neutronstriker/Programmable_Bench_Power_Supply/README.md

# Programmable_Bench_Power_Supply
An opensource Programmable benchtop Power Supply
