neutronstriker/Programmable_Bench_Power_Supply/Code/AVR/Digital_PSU/working_copy/Digital_PSU/serial cmd repl design.xlsx

Sheet: Sheet1
Prefix | Cmd Number | Aux string | cmd String | suffix | space | Comments | Var declaration | Help output prefix | help output cmd, comment sep | Help output suffix | Help output code
const char PROGMEM cmd | 1 | []=" | on | "; | // | Turn output on | const char PROGMEM cmd1[]="on"; //Turn output on | Serial.println(F_STR(" | : | ")); | Serial.println(F_STR("on : Turn output on"));
const char PROGMEM cmd | 2 | []=" | off | "; | // | Turn output off | const char PROGMEM cmd2[]="off"; //Turn output off | Serial.println(F_STR(" | : | ")); | Serial.println(F_STR("off : Turn output off"));
const char PROGMEM cmd | 3 | []=" | vbus? | "; | // | Read Voltage | const char PROGMEM cmd3[]="vbus?"; //Read Voltage | Serial.println(F_STR(" | : | ")); | Serial.println(F_STR("vbus? : Read Voltage"));
const char PROGMEM cmd | 4 | []=" | iout? | "; | // | Read Current | const char PROGMEM cmd4[]="iout?"; //Read Current | Serial.println(F_STR(" | : | ")); | Serial.println(F_STR("iout? : Read Current"));
const char PROGMEM cmd | 5 | []=" | pbus? | "; | // | Read Power | const char PROGMEM cmd5[]="pbus?"; //Read Power | Serial.println(F_STR(" | : | ")); | Serial.println(F_STR("pbus? : Read Power"));
const char PROGMEM cmd | 6 | []=" | vset | "; | // | Set Voltage | const char PROGMEM cmd6[]="vset"; //Set Voltage | Serial.println(F_STR(" | : | ")); | Serial.println(F_STR("vset : Set Voltage"));
const char PROGMEM cmd | 7 | []=" | iset | "; | // | Set Current Limit | const char PROGMEM cmd7[]="iset"; //Set Current Limit | Serial.println(F_STR(" | : | ")); | Serial.println(F_STR("iset : Set Current Limit"));
const char PROGMEM cmd | 8 | []=" | vset? | "; | // | Read Voltage set point | const char PROGMEM cmd8[]="vset?"; //Read Voltage set point | Serial.println(F_STR(" | : | ")); | Serial.println(F_STR("vset? : Read Voltage set point"));
const char PROGMEM cmd | 9 | []=" | iset? | "; | // | Read Current Limit set point | const char PROGMEM cmd9[]="iset?"; //Read Current Limit set point | Serial.println(F_STR(" | : | ")); | Serial.println(F_STR("iset? : Read Current Limit set point"));
const char PROGMEM cmd | 10 | []=" | bloff | "; | // | Turn back-light off | const char PROGMEM cmd10[]="bloff"; //Turn back-light off | Serial.println(F_STR(" | : | ")); | Serial.println(F_STR("bloff : Turn back-light off"));
const char PROGMEM cmd | 11 | []=" | blon | "; | // | Turn back-light on | const char PROGMEM cmd11[]="blon"; //Turn back-light on | Serial.println(F_STR(" | : | ")); | Serial.println(F_STR("blon : Turn back-light on"));
const char PROGMEM cmd | 12 | []=" | blon? | "; | // | Read Back-light status | const char PROGMEM cmd12[]="blon?"; //Read Back-light status | Serial.println(F_STR(" | : | ")); | Serial.println(F_STR("blon? : Read Back-light status"));
const char PROGMEM cmd | 13 | []=" | ison? | "; | // | Read Output Relay status | const char PROGMEM cmd13[]="ison?"; //Read Output Relay status | Serial.println(F_STR(" | : | ")); | Serial.println(F_STR("ison? : Read Output Relay status"));
const char PROGMEM cmd | 14 | []=" | remon | "; | // | set remote ouput on | const char PROGMEM cmd14[]="remon"; //set remote ouput on | Serial.println(F_STR(" | : | ")); | Serial.println(F_STR("remon : set remote ouput on"));
const char PROGMEM cmd | 15 | []=" | remoff | "; | // | set remote control off | const char PROGMEM cmd15[]="remoff"; //set remote control off | Serial.println(F_STR(" | : | ")); | Serial.println(F_STR("remoff : set remote control off"));
const char PROGMEM cmd | 15 | []=" | help | "; | // | will print available commands and their usage | const char PROGMEM cmd15[]="help"; //will print available commands and their usage | Serial.println(F_STR(" | : | ")); | Serial.println(F_STR("help : will print available commands and their usage"));
 |  |  | instead of remote you can use lockon and lockoff
 |  |  | and when we set voltage we also update voltage set point global var.
 |  |  | In case there are commands where first few chars are similar use the highest length char commands first and then others so that without much effort in coding we can just use strcmp
 |  |  | for example since we have "vset" and "vset?", the order should be such that "vset?" should be checked for first.

Sheet: Sheet2
iset
on
off
stat?
iset?
ibus?
vbus?
temp?
tset
help
tset?
help
