neutronstriker/Programmable_Bench_Power_Supply/buck_sch_150w.png

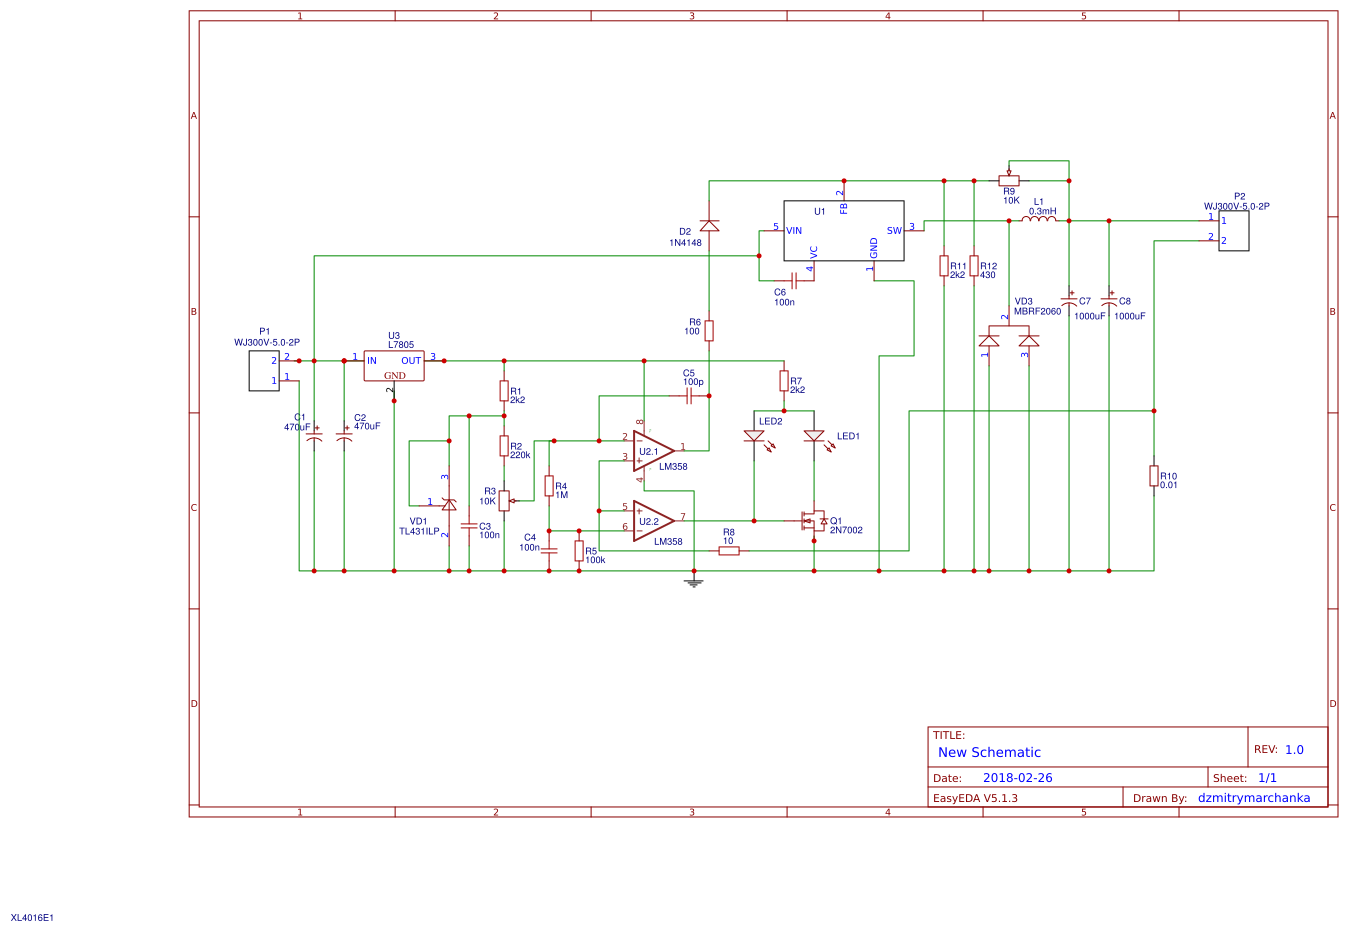
buck_sch_150w.png
