neutronstriker/Programmable_Bench_Power_Supply/DCDC_V_and_I_Controller_PCB/V2/DCDC_CTRL_PCB_TOP.png

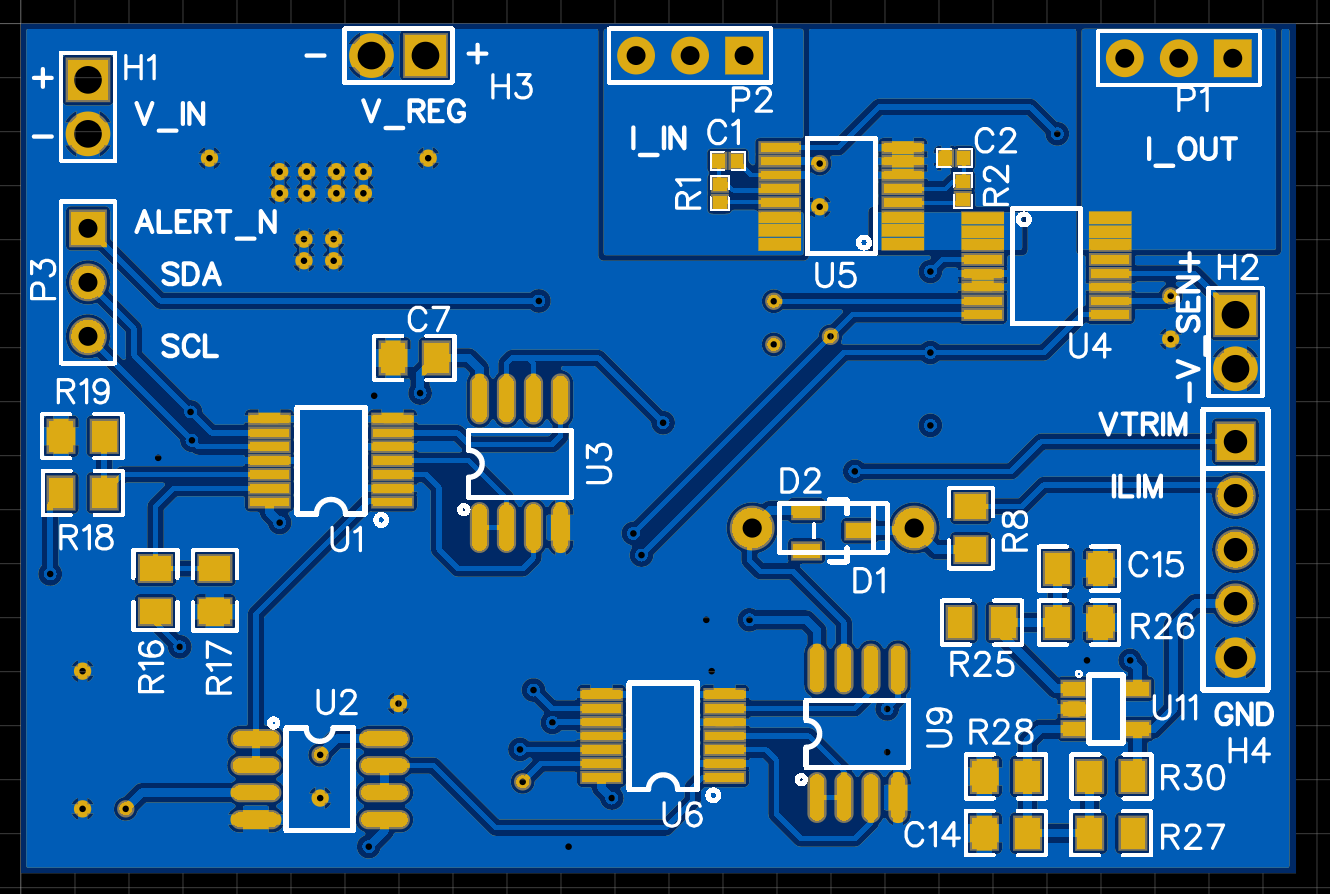
DCDC_V_and_I_Controller_PCB/V2/DCDC_CTRL_PCB_TOP.png
