neutronstriker/Programmable_Bench_Power_Supply/graph.png

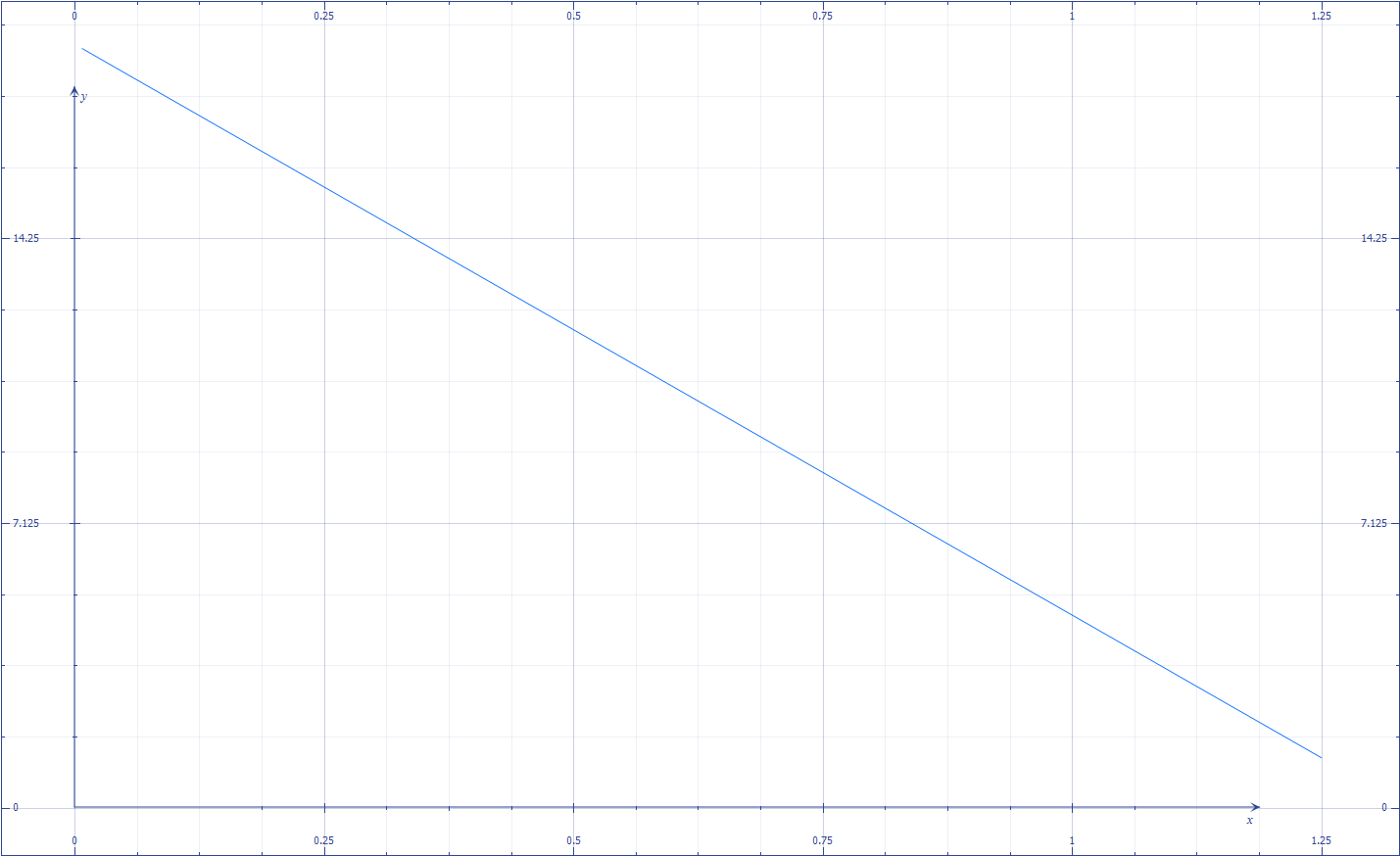
graph.png
