neutronstriker/Programmable_Bench_Power_Supply/DCDC_V_and_I_Controller_PCB/V2/BOM_Voltage Mode Buck- Voltage_Current Control Module_20190617044641.csv

ID | Name | Designator | Footprint | Quantity | Manufacturer Part | Manufacturer | Supplier | Supplier Part | MOUNT | LCSC Assembly
1 | TPL0102-100PWR | U1,U6 | TSSOP-14 | 2 | ?
2 | 0.1u | C8,C7,C9,C10,C6,C4,C13,C5,C11,C14,C15 | 0805' | 11 | ?
3 | 100 | R8 | 0805' | 1 | ?
4 | 1k | R9,R10,R12,R15,R17,R19,R3,R6,R7,R4,R20,R25,R26,R27,R28,R29,R30 | 0805' | 17 | ?
5 | 1k | R13,R14,R16,R18,R24,R5,R21,R22 | 0805' | 8 | ? |  |  |  | NO
6 | BAS16-7-F | D1 | SOT-23(SOT-23-3) | 1 | BAS16-7-F | DIODES | LCSC | C69162 |  | Yes
7 | 1N4148TA | D2 | DO-35 | 1 | 1N4148TA | FAIRCHILD | LCSC | C124481
8 | 100nF | C12 | 0805' | 1 | CL21B104JBCNNNC | SAMSUNG | LCSC | C62912 | NO | Yes
9 | 10 | R23 | 0805' | 1 | AC0805FR-0710RL | YAGEO | LCSC | C138273
10 | Header-Male-2.54_1x5 | H4 | DIP-1X5P-2.54MM-M | 1 | 210S-1*5P L=11.6MMGold-plated black | Ckmtw | LCSC | C124379
11 | INA260AIPW | U4 | TSSOP-16 | 1 | INA260AIPW | Texas Instruments | LCSC | C181331
12 | LM2937IMP-5.0 | U8 | SOT-223 | 1 | LM2937IMP-5.0 | TI | LCSC | C42249
13 | 1u | C3 | 0805' | 1 | ?
14 | LM4040C25MDBZTEP | U7 | SOT23-3 | 1 | ?
15 | INA250A3PWR | U5 | TSSOP-16 | 1 | INA250A3PWR | Texas Instruments | LCSC | C122578 |  | Yes
16 | Header-Male-2.54_1x2 | H1,H2,H3 | HDR-2X1/2.54 | 3 | 826629-2 | TE Connectivity | LCSC | C86471
17 | Header-Male-2.54_1x3 | P1,P2,P3 | HDR-3X1/2.54 | 3 | Header2.54mm 1*3P | BOOMELE | LCSC | C49257
18 | 10 | R2,R1 | 0402' | 2 | ?
19 | 100nF | C2,C1 | 0402' | 2 | ?
20 | 0 | R11 | 0805' | 1 | ?
21 | TL331IDBVR | U11 | SOT-23-5 | 1 | TL331IDBVR | TI | LCSC | C80942 |  | Yes
22 | OPA2188AIDR | U3,U9,U2 | SOIC-8_150MIL | 3 | OPA2188AIDR | TI | LCSC | C17271
