neutronstriker/Programmable_Bench_Power_Supply/Mechanicals/Base.stl

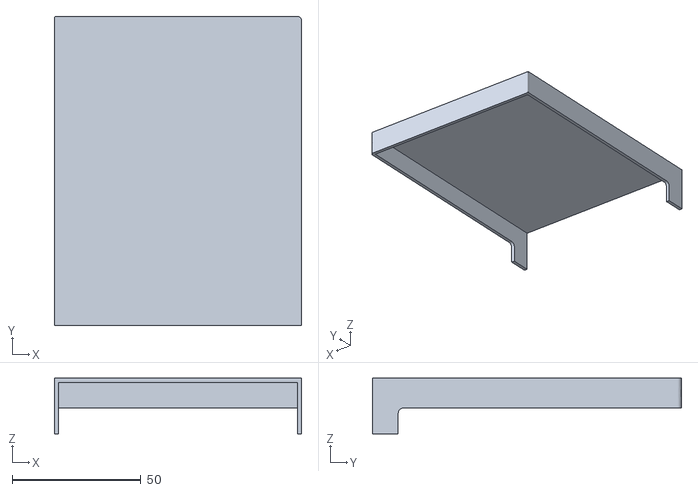
[picture p5: CAD file, 2024-03-05]
Mechanicals/Base.stl
96.0 x 120.0 x 21.6
