neutronstriker/Programmable_Bench_Power_Supply/Mechanicals/Front_Panel.stl

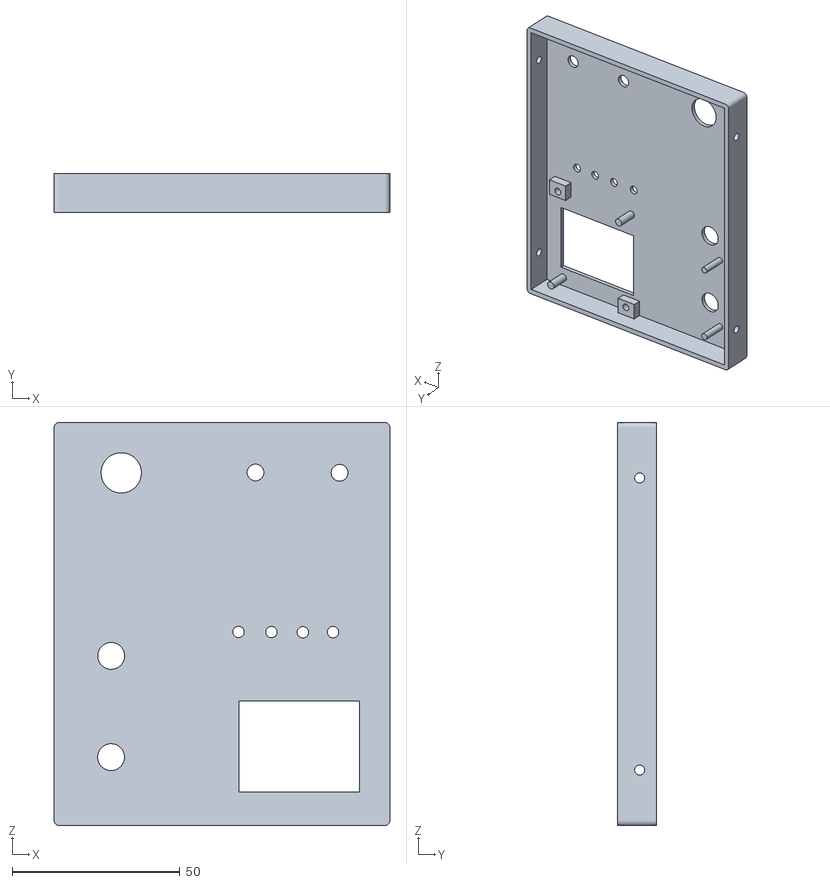
[picture p6: CAD file, 2024-03-05]
Mechanicals/Front_Panel.stl
100.0 x 11.6 x 120.0
