neutronstriker/Programmable_Bench_Power_Supply/DCDC_V_and_I_Controller_PCB/V1/PCB_1A.dxf

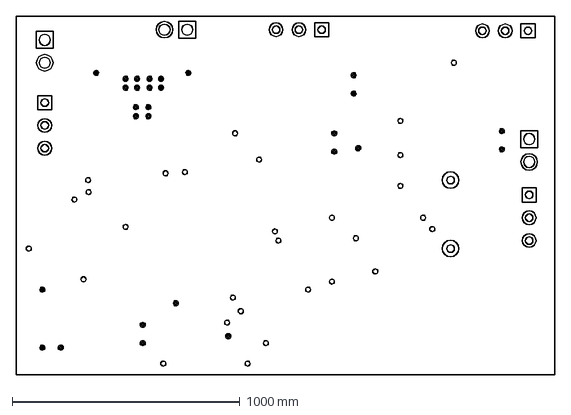
[picture p7: CAD file, 2024-03-05, an earlier design]
DCDC_V_and_I_Controller_PCB/V1/PCB_1A.dxf
2362.2 x 1574.8 mm
