neutronstriker/Programmable_Bench_Power_Supply/Code/AVR/Digital_PSU/working_copy/Digital_PSU/Voltage_Shmoo_plots/V-shmoo_100mV_steps_mcp4725.xlsx

INA VBUS Reading | Setting Voltage | Error
1380 | 1400 | 20
1481 | 1500 | 19
1579 | 1600 | 21
1684 | 1700 | 16
1782 | 1800 | 18
1879 | 1900 | 21
1977 | 2000 | 23
2076 | 2100 | 24
2175 | 2200 | 25
2265 | 2300 | 35
2364 | 2400 | 36
2461 | 2500 | 39
2559 | 2600 | 41
2660 | 2700 | 40
2760 | 2800 | 40
2860 | 2900 | 40
2970 | 3000 | 30
3069 | 3100 | 31
3161 | 3200 | 39
3257 | 3300 | 43
3356 | 3400 | 44
3454 | 3500 | 46
3550 | 3600 | 50
3650 | 3700 | 50
3755 | 3800 | 45
3855 | 3900 | 45
3952 | 4000 | 48
4055 | 4100 | 45
4150 | 4200 | 50
4249 | 4300 | 51
4344 | 4400 | 56
4445 | 4500 | 55
4540 | 4600 | 60
4639 | 4700 | 61
4740 | 4800 | 60
4836 | 4900 | 64
4933 | 5000 | 67
5031 | 5100 | 69
5134 | 5200 | 66
5231 | 5300 | 69
5328 | 5400 | 72
5422 | 5500 | 78
5524 | 5600 | 76
5623 | 5700 | 77
5719 | 5800 | 81
5822 | 5900 | 78
5922 | 6000 | 78
6023 | 6100 | 77
6121 | 6200 | 79
6225 | 6300 | 75
6322 | 6400 | 78
6420 | 6500 | 80
6520 | 6600 | 80
6618 | 6700 | 82
6716 | 6800 | 84
6816 | 6900 | 84
6921 | 7000 | 79
7018 | 7100 | 82
7115 | 7200 | 85
7217 | 7300 | 83
7315 | 7400 | 85
7414 | 7500 | 86
7513 | 7600 | 87
7612 | 7700 | 88
7706 | 7800 | 94
7805 | 7900 | 95
7906 | 8000 | 94
8006 | 8100 | 94
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
