neutronstriker/Programmable_Bench_Power_Supply/Code/AVR/Digital_PSU/working_copy/Digital_PSU/Voltage_Shmoo_plots/V-shmoo_100mV_steps_mcp4725_after_trf_2_after_VTrimRounding.xlsx

Setting Voltage | INA VBUS Reading | Error
1.4 | 1.384 | 0.016
1.5 | 1.485 | 0.015
1.6 | 1.59 | 0.01
1.7 | 1.69 | 0.01
1.8 | 1.789 | 0.011
1.9 | 1.889 | 0.011
2 | 1.989 | 0.011
2.1 | 2.087 | 0.013
2.2 | 2.19 | 0.01
2.3 | 2.289 | 0.011
2.4 | 2.386 | 0.014
2.5 | 2.487 | 0.013
2.6 | 2.582 | 0.018
2.7 | 2.686 | 0.014
2.8 | 2.791 | 0.009
2.9 | 2.9 | 0
3 | 3.004 | -0.004
3.1 | 3.102 | -0.002
3.2 | 3.196 | 0.004
3.3 | 3.297 | 0.003
3.4 | 3.398 | 0.002
3.5 | 3.494 | 0.006
3.6 | 3.597 | 0.003
3.7 | 3.702 | -0.002
3.8 | 3.802 | -0.002
3.9 | 3.905 | -0.005
4 | 4.009 | -0.009
4.1 | 4.106 | -0.006
4.2 | 4.208 | -0.008
4.3 | 4.306 | -0.006
4.4 | 4.402 | -0.002
4.5 | 4.504 | -0.004
4.6 | 4.601 | -0.001
4.7 | 4.703 | -0.003
4.8 | 4.804 | -0.004
4.9 | 4.9 | 0
5 | 5.003 | -0.003
5.1 | 5.105 | -0.005
5.2 | 5.203 | -0.003
5.3 | 5.304 | -0.004
5.4 | 5.404 | -0.004
5.5 | 5.505 | -0.005
5.6 | 5.603 | -0.003
5.7 | 5.705 | -0.005
5.8 | 5.808 | -0.008
5.9 | 5.907 | -0.007
6 | 6.011 | -0.011
6.1 | 6.116 | -0.016
6.2 | 6.214 | -0.014
6.3 | 6.316 | -0.016
6.4 | 6.414 | -0.014
6.5 | 6.515 | -0.015
6.6 | 6.616 | -0.016
6.7 | 6.716 | -0.016
6.8 | 6.82 | -0.02
6.9 | 6.924 | -0.024
7 | 7.021 | -0.021
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
