neutronstriker/Programmable_Bench_Power_Supply/Code/AVR/Digital_PSU/working_copy/Digital_PSU/Voltage_Shmoo_plots/V-shmoo_10mV_steps.xlsx

Setting Voltage | INA VBUS Reading | error
1.4 | 1.374 | 0.026 | Max | 18000
1.41 | 1.371 | 0.039 | Min | 1400
1.42 | 1.374 | 0.046 | Diff | 16600
1.43 | 1.372 | 0.058 | DAC Code max | 256
1.44 | 1.371 | 0.069 | Step size | 64.84375
1.45 | 1.376 | 0.074
1.46 | 1.449 | 0.011 | 1.515 | 1.442
1.47 | 1.446 | 0.024 | 1.585 | 1.514
1.48 | 1.442 | 0.038 | 0.07 | 0.072
1.49 | 1.442 | 0.048
1.5 | 1.445 | 0.055
1.51 | 1.446 | 0.064
1.52 | 1.444 | 0.076
1.53 | 1.52 | 0.01
1.54 | 1.515 | 0.025
1.55 | 1.521 | 0.029
1.56 | 1.52 | 0.04
1.57 | 1.519 | 0.051
1.58 | 1.515 | 0.065
1.59 | 1.514 | 0.076
1.6 | 1.585 | 0.015
1.61 | 1.586 | 0.024
1.62 | 1.591 | 0.029
1.63 | 1.585 | 0.045
1.64 | 1.585 | 0.055
1.65 | 1.591 | 0.059
1.66 | 1.585 | 0.075
1.67 | 1.657 | 0.013
1.68 | 1.657 | 0.023
1.69 | 1.657 | 0.033
1.7 | 1.66 | 0.04
1.71 | 1.661 | 0.049
1.72 | 1.657 | 0.063
1.73 | 1.66 | 0.07
1.74 | 1.729 | 0.011
1.75 | 1.727 | 0.023
1.76 | 1.73 | 0.03
1.77 | 1.729 | 0.041
1.78 | 1.729 | 0.051
1.79 | 1.729 | 0.061
1.8 | 1.73 | 0.07
1.81 | 1.729 | 0.081
1.82 | 1.801 | 0.019
1.83 | 1.801 | 0.029
1.84 | 1.801 | 0.039
1.85 | 1.801 | 0.049
1.86 | 1.801 | 0.059
1.87 | 1.801 | 0.069
1.88 | 1.801 | 0.079
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
