neutronstriker/Programmable_Bench_Power_Supply/Code/AVR/Digital_PSU/working_copy/Digital_PSU/Voltage_Shmoo_plots/V-shmoo_10mV_steps_mcp4725.xlsx

Sheet: V-shmoo_10mV_steps_mcp4725
INA VBUS Reading | Setting Voltage | Error | predicted setpoint
1376 | 1400 | 24 | 1366.956811 | 33.0431885 | Probably we can improve the transfer function by using Piece wise continous data whenever the error between predicted value to required value changes sign.
1391 | 1410 | 19 | 1382.188209 | 27.81179085
1405 | 1420 | 15 | 1396.40418 | 23.59581971
1413 | 1430 | 17 | 1404.527592 | 25.47240763
1422 | 1440 | 18 | 1413.666431 | 26.33356904
1429 | 1450 | 21 | 1420.774417 | 29.22558347
1440 | 1460 | 20 | 1431.944108 | 28.05589186
1447 | 1470 | 23 | 1439.052094 | 30.94790629
1457 | 1480 | 23 | 1449.206359 | 30.79364119
1466 | 1490 | 24 | 1458.345197 | 31.6548026
1482 | 1500 | 18 | 1474.592022 | 25.40797844
1492 | 1510 | 18 | 1484.746287 | 25.25371334
1501 | 1520 | 19 | 1493.885125 | 26.11487475
1511 | 1530 | 19 | 1504.03939 | 25.96060965
1517 | 1540 | 23 | 1510.131949 | 29.86805059
1530 | 1550 | 20 | 1523.332494 | 26.66750596
1536 | 1560 | 24 | 1529.425053 | 30.5749469
1547 | 1570 | 23 | 1540.594745 | 29.40525529
1559 | 1580 | 21 | 1552.779863 | 27.22013717
1572 | 1590 | 18 | 1565.980407 | 24.01959254
1584 | 1600 | 16 | 1578.165526 | 21.83447442
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
