neutronstriker/Programmable_Bench_Power_Supply/Code/AVR/Digital_PSU/v1/testOut_11.xlsx

Setting Voltage | INA VBUS Reading | INA Shunt Current | Error | % error
1.4 | 1.435 | 0.034 | -0.035 | -2.5%
1.5 | 1.51 | 0.035 | -0.01 | -0.6666666667%
1.6 | 1.571 | 0.032 | 0.029 | 1.8125%
1.7 | 1.721 | 0.034 | -0.021 | -1.235294118%
1.8 | 1.792 | 0.035 | 0.008 | 0.4444444444%
1.9 | 1.935 | 0.034 | -0.035 | -1.842105263%
2 | 2.005 | 0.035 | -0.005 | -0.25%
2.1 | 2.079 | 0.034 | 0.021 | 1%
2.2 | 2.219 | 0.032 | -0.019 | -0.8636363636%
2.3 | 2.292 | 0.032 | 0.008 | 0.347826087%
2.4 | 2.431 | 0.034 | -0.031 | -1.291666667%
2.5 | 2.506 | 0.034 | -0.006 | -0.24%
2.6 | 2.576 | 0.034 | 0.024 | 0.9230769231%
2.7 | 2.719 | 0.035 | -0.019 | -0.7037037037%
2.8 | 2.79 | 0.032 | 0.01 | 0.3571428571%
2.9 | 2.931 | 0.034 | -0.031 | -1.068965517%
3 | 3.002 | 0.032 | -0.002 | -0.06666666667%
3.1 | 3.074 | 0.035 | 0.026 | 0.8387096774%
3.2 | 3.214 | 0.034 | -0.014 | -0.4375%
3.3 | 3.287 | 0.034 | 0.013 | 0.3939393939%
3.4 | 3.417 | 0.031 | -0.017 | -0.5%
3.5 | 3.497 | 0.032 | 0.003 | 0.08571428571%
3.6 | 3.561 | 0.035 | 0.039 | 1.083333333%
3.7 | 3.705 | 0.034 | -0.005 | -0.1351351351%
3.8 | 3.771 | 0.034 | 0.029 | 0.7631578947%
3.9 | 3.925 | 0.032 | -0.025 | -0.641025641%
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
