neutronstriker/Programmable_Bench_Power_Supply/Code/AVR/Digital_PSU/v1/testOut_V_final.xlsx

Setting Voltage | INA VBUS Reading | Setting error | % error
1500 | 1.431 | 69 | 4.6%
1600 | 1.501 | 99 | 6.2%
1700 | 1.647 | 53 | 3.1%
1800 | 1.72 | 80 | 4.4%
1900 | 1.864 | 36 | 1.9%
2000 | 1.934 | 66 | 3.3%
2100 | 2.001 | 99 | 4.7%
2200 | 2.14 | 60 | 2.7%
2300 | 2.21 | 90 | 3.9%
2400 | 2.355 | 45 | 1.9%
2500 | 2.425 | 75 | 3.0%
2600 | 2.496 | 104 | 4.0%
2700 | 2.638 | 62 | 2.3%
2800 | 2.706 | 94 | 3.4%
2900 | 2.846 | 54 | 1.9%
3000 | 2.919 | 81 | 2.7%
3100 | 2.991 | 109 | 3.5%
3200 | 3.134 | 66 | 2.1%
3300 | 3.207 | 93 | 2.8%
3400 | 3.347 | 53 | 1.6%
3500 | 3.417 | 83 | 2.4%
3600 | 3.486 | 114 | 3.2%
3700 | 3.629 | 71 | 1.9%
3800 | 3.702 | 98 | 2.6%
3900 | 3.841 | 59 | 1.5%
4000 | 3.911 | 89 | 2.2%
4100 | 3.984 | 116 | 2.8%
4200 | 4.13 | 70 | 1.7%
4300 | 4.201 | 99 | 2.3%
4400 | 4.274 | 126 | 2.9%
4500 | 4.406 | 94 | 2.1%
4600 | 4.48 | 120 | 2.6%
4700 | 4.62 | 80 | 1.7%
4800 | 4.69 | 110 | 2.3%
4900 | 4.763 | 137 | 2.8%
5000 | 4.902 | 98 | 2.0%
5100 | 4.978 | 122 | 2.4%
5200 | 5.123 | 77 | 1.5%
5300 | 5.191 | 109 | 2.1%
5400 | 5.264 | 136 | 2.5%
5500 | 5.406 | 94 | 1.7%
5600 | 5.475 | 125 | 2.2%
5700 | 5.618 | 82 | 1.4%
5800 | 5.688 | 112 | 1.9%
5900 | 5.756 | 144 | 2.4%
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
