neutronstriker/Programmable_Bench_Power_Supply/Code/AVR/Digital_PSU/v1/testOut_V_final_2.xlsx

Setting Voltage | INA VBUS Reading | Error | % error
1.4 | 1.33 | 0.07 | 5.00%
1.5 | 1.431 | 0.069 | 4.60%
1.6 | 1.501 | 0.099 | 6.19% | 10mA load was used for voltage stability
1.7 | 1.647 | 0.053 | 3.12%
1.8 | 1.72 | 0.08 | 4.44%
1.9 | 1.864 | 0.036 | 1.89%
2 | 1.934 | 0.066 | 3.30%
2.1 | 2.001 | 0.099 | 4.71%
2.2 | 2.14 | 0.06 | 2.73%
2.3 | 2.21 | 0.09 | 3.91%
2.4 | 2.355 | 0.045 | 1.87%
2.5 | 2.425 | 0.075 | 3.00%
2.6 | 2.496 | 0.104 | 4.00%
2.7 | 2.638 | 0.062 | 2.30%
2.8 | 2.706 | 0.094 | 3.36%
2.9 | 2.846 | 0.054 | 1.86%
3 | 2.919 | 0.081 | 2.70%
3.1 | 2.991 | 0.109 | 3.52%
3.2 | 3.134 | 0.066 | 2.06%
3.3 | 3.207 | 0.093 | 2.82%
3.4 | 3.347 | 0.053 | 1.56%
3.5 | 3.417 | 0.083 | 2.37%
3.6 | 3.486 | 0.114 | 3.17%
3.7 | 3.629 | 0.071 | 1.92%
3.8 | 3.702 | 0.098 | 2.58%
3.9 | 3.841 | 0.059 | 1.51%
4 | 3.911 | 0.089 | 2.22%
4.1 | 3.984 | 0.116 | 2.83%
4.2 | 4.13 | 0.07 | 1.67%
4.3 | 4.201 | 0.099 | 2.30%
4.4 | 4.274 | 0.126 | 2.86%
4.5 | 4.406 | 0.094 | 2.09%
4.6 | 4.48 | 0.12 | 2.61%
4.7 | 4.62 | 0.08 | 1.70%
4.8 | 4.69 | 0.11 | 2.29%
4.9 | 4.763 | 0.137 | 2.80%
5 | 4.902 | 0.098 | 1.96%
5.1 | 4.978 | 0.122 | 2.39%
5.2 | 5.123 | 0.077 | 1.48%
5.3 | 5.191 | 0.109 | 2.06%
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
