neutronstriker/Programmable_Bench_Power_Supply/Code/AVR/Digital_PSU/v1/R-2R_DAC_test.csv

TCA P0 Val | Voltage | step size | DNL | INL | Linear Model | Error
0 | 0.563 |  |  | -0.028713 | -0.84467292 | 1.40767292 | Vref | 5000
1 | 15.562 | 14.999 | -0.235051 | 0.206338 | 18.74769369 | -3.185693685 | Step size | 19.60784314
2 | 38.062 | 22.5 | 0.1475 | 0.058838 | 38.34006029 | -0.27806029
3 | 52.875 | 14.813 | -0.244537 | 0.303375 | 57.9324269 | -5.057426895
4 | 78.375 | 25.5 | 0.3005 | 0.002875 | 77.5247935 | 0.8502065
5 | 93.375 | 15 | -0.235 | 0.237875 | 97.11716011 | -3.742160105 |  | So if we make a 16bit DAC, we should not try to model the Code vs Voltage out of DAC,
6 | 115.875 | 22.5 | 0.1475 | 0.090375 | 116.7095267 | -0.83452671 |  | rather model the code vs Voltage out of DCDC, and we will get a better model fit, because of lower number
7 | 130.688 | 14.813 | -0.244537 | 0.334912 | 136.3018933 | -5.613893315 |  | of points probably.
8 | 159.938 | 29.25 | 0.49175 | -0.156838 | 155.8942599 | 4.04374008
9 | 174.75 | 14.812 | -0.244588 | 0.08775 | 175.4866265 | -0.736626525
10 | 197.25 | 22.5 | 0.1475 | -0.05975 | 195.0789931 | 2.17100687
11 | 212.25 | 15 | -0.235 | 0.17525 | 214.6713597 | -2.421359735
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
