neutronstriker/Programmable_Bench_Power_Supply/Code/AVR/Digital_PSU/v1/testOut_1.csv

`f`xf æ€f` xø†f ˜
˜€ `æ€˜€
f† ~`fžøž~ fþžàž`fæxf † `
fà˜à˜à˜æ fþžàž`fæxf ˜fx x†žøž~f€˜€ ˜à † †f˜ø˜
˜€ xà† ˜à †f˜xæ€˜€ ˜xà† xø†f ˜
˜€DEVICE_INITIALISED
Setting Voltage | ADS1115 Voltage Reading
101 | 100.59
102 | 101.56
103 | 102.50
104 | 103.44
105 | 104.41
106 | 105.37
107 | 106.34
108 | 107.28
109 | 108.25
110 | 109.22
111 | 110.16
112 | 111.09
113 | 112.06
114 | 113.03
115 | 113.97
116 | 114.94
117 | 115.91
118 | 116.87
119 | 117.81
120 | 118.78
121 | 119.75
122 | 120.72
123 | 121.66
124 | 123.56
125 | 124.53
126 | 125.47
127 | 126.41
128 | 127.37
129 | 128.34
130 | 129.28
131 | 130.25
132 | 131.22
133 | 132.19
134 | 133.13
135 | 134.06
136 | 135.06
137 | 136.00
138 | 136.97
139 | 137.88
140 | 138.84
141 | 139.81
142 | 140.78
143 | 141.72
144 | 142.66
145 | 143.63
146 | 144.59
147 | 145.56
148 | 146.53
149 | 148.44
150 | 149.38
151 | 150.34
152 | 151.31
153 | 152.25
154 | 153.22
155 | 154.16
156 | 155.13
157 | 156.06
158 | 157.00
159 | 157.97
160 | 158.94
161 | 159.91
162 | 160.84
163 | 161.81
164 | 162.78
165 | 163.72
166 | 164.69
167 | 165.66
168 | 166.59
169 | 167.56
170 | 168.50
171 | 169.47
172 | 170.41
173 | 171.38
174 | 173.28
175 | 174.22
176 | 175.19
177 | 176.16
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
