neutronstriker/Programmable_Bench_Power_Supply/Code/AVR/Digital_PSU/v1/testOut_10.csv

Setting Voltage | INA VBUS ReadingINA Shunt Current
1400 | 1.394 | 0.21
1500 | 1.447 | 0.21
1600 | 1.535 | 0.212
1700 | 1.674 | 0.215
1800 | 1.749 | 0.214
1900 | 1.89 | 0.215
2000 | 1.959 | 0.214
2100 | 2.032 | 0.214
2200 | 2.17 | 0.215
2300 | 2.241 | 0.212
2400 | 2.644 | 0.207
2500 | 2.564 | 0.207
2600 | 2.54 | 0.209
2700 | 2.645 | 0.212
2800 | 2.765 | 0.211
2900 | 2.937 | 0.209
3000 | 2.999 | 0.209
3100 | 2.962 | 0.211
3200 | 3.249 | 0.211
3300 | 3.27 | 0.211
3400 | 3.335 | 0.214
3500 | 3.46 | 0.21
3600 | 3.509 | 0.21
3700 | 3.659 | 0.214
3800 | 3.719 | 0.21
3900 | 3.864 | 0.212
4000 | 3.935 | 0.21
4100 | 4.006 | 0.212
4200 | 4.149 | 0.214
4300 | 4.219 | 0.214
4400 | 4.291 | 0.212
4500 | 4.431 | 0.212
4600 | 4.504 | 0.21
4700 | 4.645 | 0.21
4800 | 4.715 | 0.212
4900 | 4.786 | 0.214
5000 | 4.929 | 0.211
5100 | 4.995 | 0.212
5200 | 5.138 | 0.211
5300 | 5.209 | 0.212
5400 | 5.281 | 0.212
5500 | 5.42 | 0.214
5600 | 5.493 | 0.211
5700 | 5.63 | 0.211
5800 | 5.704 | 0.212
5900 | 5.774 | 0.214
6000 | 5.914 | 0.212
6100 | 5.985 | 0.212
6200 | 6.128 | 0.211
6300 | 6.196 | 0.211
6400 | 6.268 | 0.21
6500 | 6.409 | 0.212
6600 | 6.48 | 0.212
6700 | 6.623 | 0.211
6800 | 6.691 | 0.211
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
