neutronstriker/Programmable_Bench_Power_Supply/Code/AVR/Digital_PSU/v1/testOut_11.csv

Setting Voltage | INA VBUS Reading | INA Shunt Current | Error | % error
1.4 | 1.435 | 0.034 | -0.035 | -3%
1.5 | 1.51 | 0.035 | -0.01 | -1%
1.6 | 1.571 | 0.032 | 0.029 | 2%
1.7 | 1.721 | 0.034 | -0.021 | -1%
1.8 | 1.792 | 0.035 | 0.008 | 0%
1.9 | 1.935 | 0.034 | -0.035 | -2%
2 | 2.005 | 0.035 | -0.005 | 0%
2.1 | 2.079 | 0.034 | 0.021 | 1%
2.2 | 2.219 | 0.032 | -0.019 | -1%
2.3 | 2.292 | 0.032 | 0.008 | 0%
2.4 | 2.431 | 0.034 | -0.031 | -1%
2.5 | 2.506 | 0.034 | -0.006 | 0%
2.6 | 2.576 | 0.034 | 0.024 | 1%
2.7 | 2.719 | 0.035 | -0.019 | -1%
2.8 | 2.79 | 0.032 | 0.01 | 0%
2.9 | 2.931 | 0.034 | -0.031 | -1%
3 | 3.002 | 0.032 | -0.002 | 0%
3.1 | 3.074 | 0.035 | 0.026 | 1%
3.2 | 3.214 | 0.034 | -0.014 | 0%
3.3 | 3.287 | 0.034 | 0.013 | 0%
3.4 | 3.417 | 0.031 | -0.017 | 0%
3.5 | 3.497 | 0.032 | 0.003 | 0%
3.6 | 3.561 | 0.035 | 0.039 | 1%
3.7 | 3.705 | 0.034 | -0.005 | 0%
3.8 | 3.771 | 0.034 | 0.029 | 1%
3.9 | 3.925 | 0.032 | -0.025 | -1%
4 | 3.985 | 0.032 | 0.015 | 0%
4.1 | 4.071 | 0.032 | 0.029 | 1%
4.2 | 4.206 | 0.032 | -0.006 | 0%
4.3 | 4.268 | 0.034 | 0.032 | 1%
4.4 | 4.421 | 0.034 | -0.021 | 0%
4.5 | 4.49 | 0.034 | 0.01 | 0%
4.6 | 4.561 | 0.032 | 0.039 | 1%
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
