neutronstriker/Programmable_Bench_Power_Supply/DCDC_V_and_I_Controller_PCB/V1/Schematic_Voltage-Mode-Buck--Voltage-Current-Control-Module_20190531024835.pdf

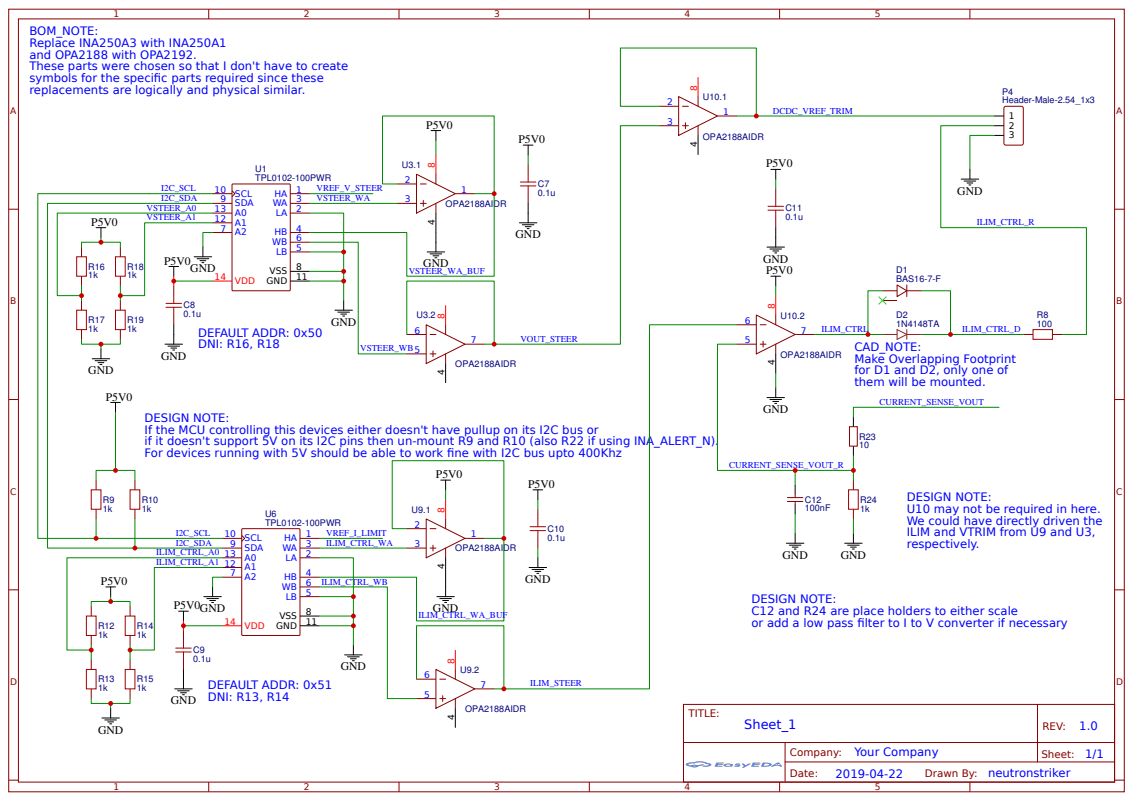
[picture p10: page 1]

BOM_NOTE:
Replace INA250A3 with INA250A1
and OPA2188 with OPA2192.
These parts were chosen so that I don't have to create
symbols for the specific parts required since these
replacements are logically and physical similar.

CAD_NOTE:
Make Overlapping Footprint
for D1 and D2, only one of
them will be mounted.

GND
DESIGN NOTE:
If the MCU controlling this devices either doesn't have pullup on its I2C bus or
if it doesn't support 5V on its I2C pins then un-mount R9 and R10 (also R22 if using INA_ALERT_N).
For devices running with 5V should be able to work fine with I2C bus upto 400Khz

U10 may not be required in here.
We could have directly driven the
ILIM and VTRIM from U9 and U3,
respectively.

C12 and R24 are place holders to either scale
or add a low pass filter to I to V converter if necessary

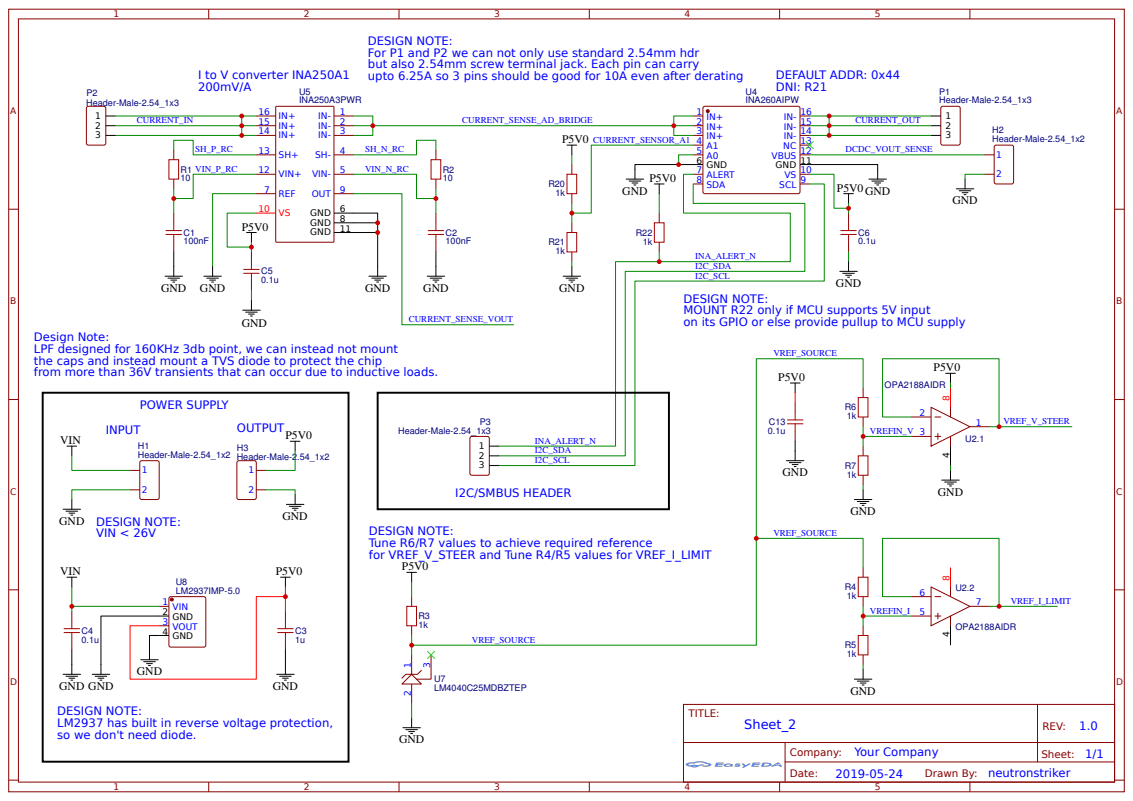
[picture p11: page 2]

DESIGN NOTE:
For P1 and P2 we can not only use standard 2.54mm hdr
but also 2.54mm screw terminal jack. Each pin can carry
upto 6.25A so 3 pins should be good for 10A even after derating

on its GPIO or else provide pullup to MCU supply CURRENT_SENSE_VOUT

Design Note:
LPF designed for 160KHz 3db point, we can instead not mount
the caps and instead mount a TVS diode to protect the chip
from more than 36V transients that can occur due to inductive loads.

Tune R6/R7 values to achieve required reference
for VREF_V_STEER and Tune R4/R5 values for VREF_I_LIMIT

GND
LM2937 has built in reverse voltage protection,
so we don't need diode.
