neutronstriker/Programmable_Bench_Power_Supply/(list of files, drawings)

Other design files:
DCDC_V_and_I_Controller_PCB/V1/PCB_1A.pcbdoc
DCDC_V_and_I_Controller_PCB/V2/PCB_1A.json
DCDC_V_and_I_Controller_PCB/V2/PCB_1A.pcbdoc
