neutronstriker/Programmable_Bench_Power_Supply/(notices)

Notices in the files:
Code/AVR/Digital_PSU/working_copy/Digital_PSU/INA260/INA260.h:
This program is free software: you can redistribute it and/or modify
it under the terms of the version 3 GNU General Public License as
published by the Free Software Foundation.
